songcn206/UnMannedParachuteController/Mechanics/Parts/LangevarjuKarpver2.SLDASM

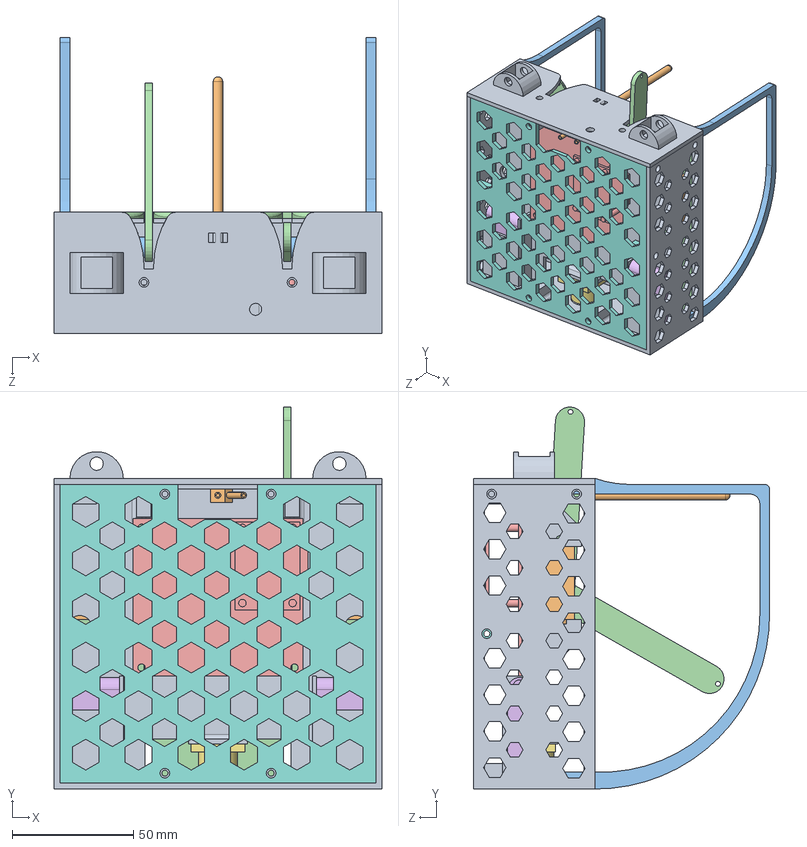
[picture p1: CAD file, 2020-04-21]
Mechanics/Parts/LangevarjuKarpver2.SLDASM
135.0 x 157.4 x 122.0 mm
LangevarjuKarbiSkelettVer2
FeetechFT1117MMotor x 2
MootoriAdapterVer2 x 2
Esisein
MainboardRev1
NanotechBattery x 2
SonarMB1023
Tagasein
Katus
PitotToru
Kaitsekaar x 2
Käppver2 x 2
