songcn206/UnMannedParachuteController/Mechanics/Parts/LangevarjuKarpver3.SLDASM

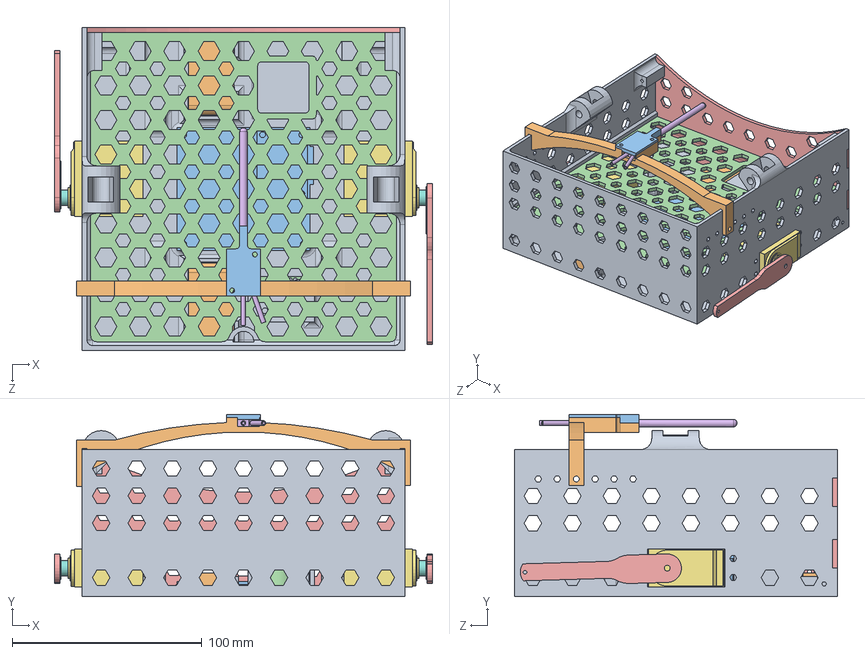
[picture p2: CAD file, 2020-03-24]
Mechanics/Parts/LangevarjuKarpver3.SLDASM
199.2 x 96.1 x 170.0 mm
LangevarjuKarbiSkelettVer3
NanotechBattery x 2
MainboardRev1
SonarMB1023
Käpp x 2
PitotToru
PololuAB3606HB x 2
MootoriAdapterVer3 x 2
GPSantenn
Pitotkaat
Pitotkatus
Vahekatusver3
Esiseinver3
