songcn206/UnMannedParachuteController/Mechanics/Parts/MainboardRev1.SLDPRT

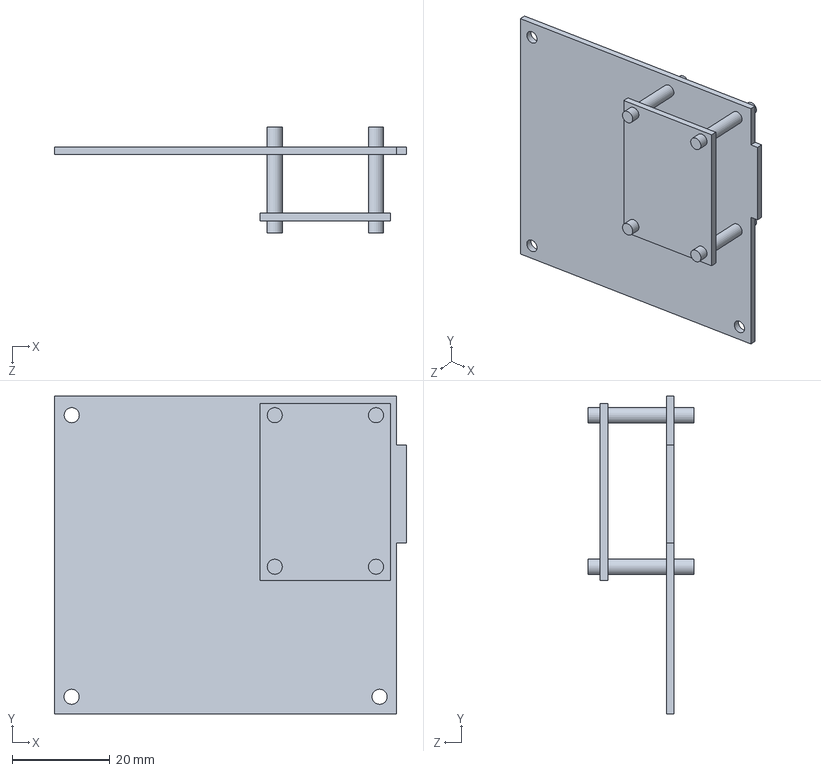
[picture p3: CAD file, 2020-03-01]
Mechanics/Parts/MainboardRev1.SLDPRT
72.0 x 65.0 x 21.6 mm
