songcn206/UnMannedParachuteController/Mechanics/Parts/NööriAas.SLDPRT

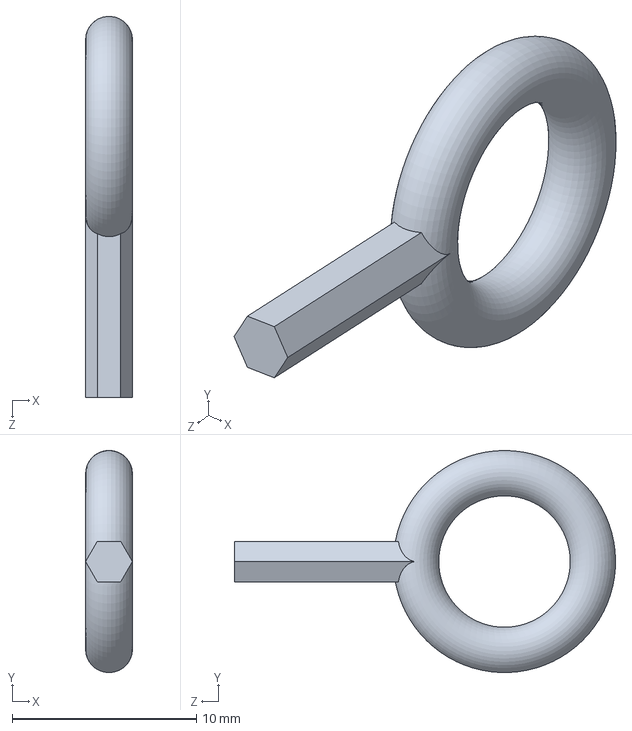
[picture p4: CAD file, 2020-04-21]
Mechanics/Parts/NööriAas.SLDPRT
2.54 x 12.1 x 20.7 mm
