songcn206/UnMannedParachuteController/Mechanics/Parts/Ver1esitagasein.SLDPRT

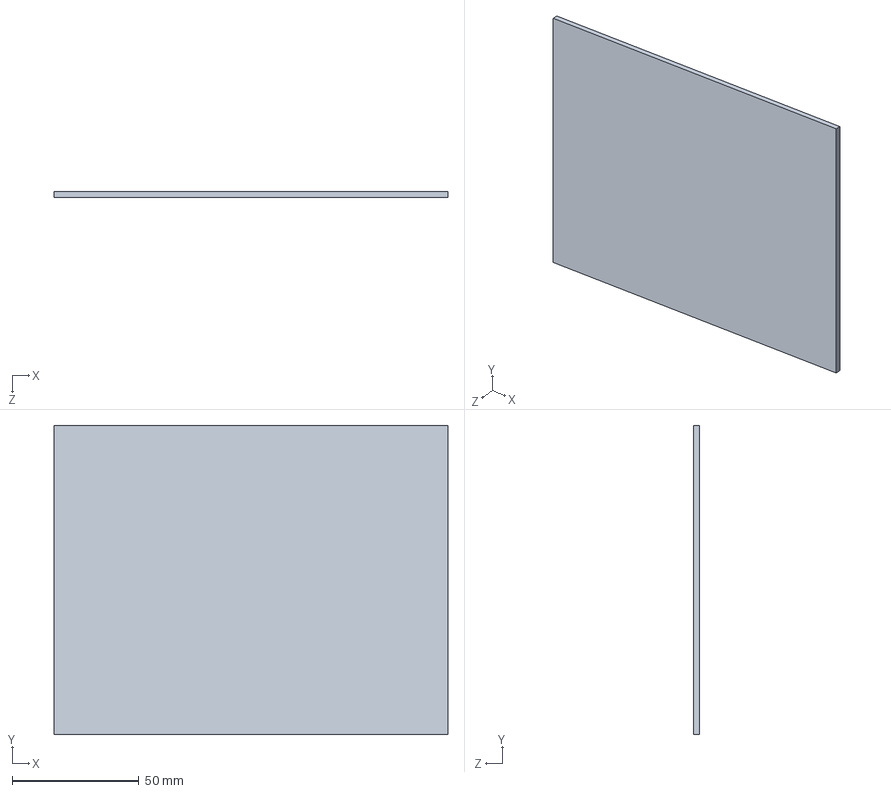
[picture p5: CAD file, 2020-04-21]
Mechanics/Parts/Ver1esitagasein.SLDPRT
155.4 x 122.0 x 2.50 mm
