songcn206/UnMannedParachuteController/Mechanics/Parts/TestRack.SLDPRT

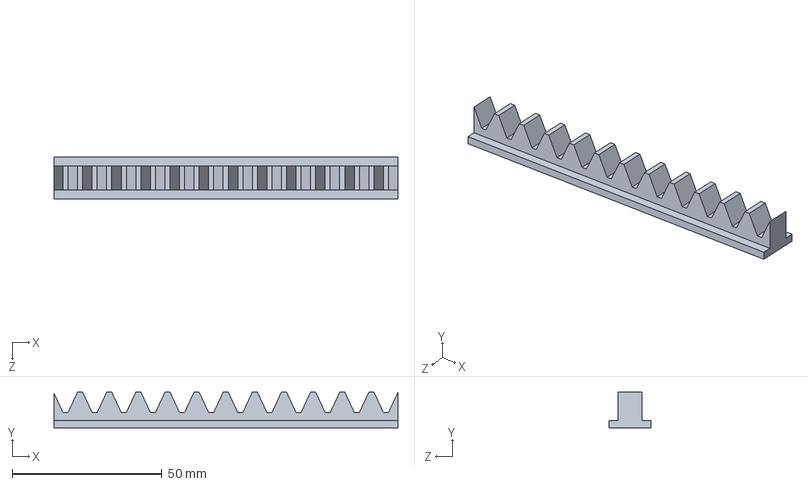
[picture p6: CAD file, 2020-04-21]
Mechanics/Parts/TestRack.SLDPRT
115.0 x 12.0 x 14.0 mm
