songcn206/UnMannedParachuteController/Mechanics/Parts/Esisein.SLDPRT

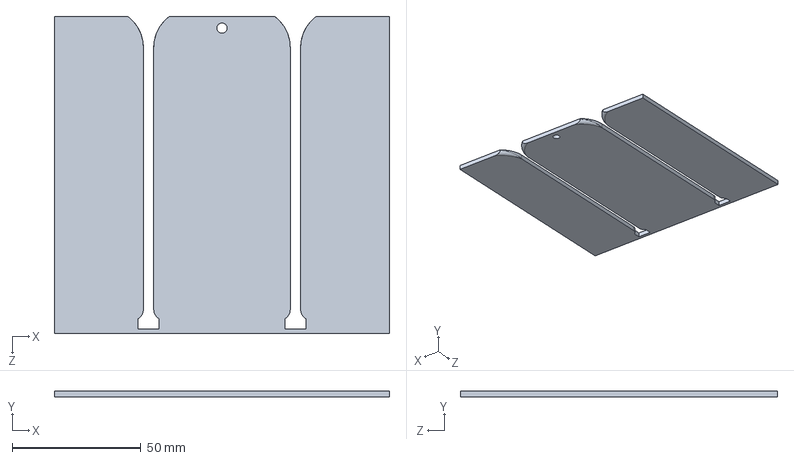
[picture p7: CAD file, 2020-04-21]
Mechanics/Parts/Esisein.SLDPRT
130.0 x 2.50 x 123.0 mm
