songcn206/UnMannedParachuteController/Mechanics/Parts/ver1katus.SLDPRT

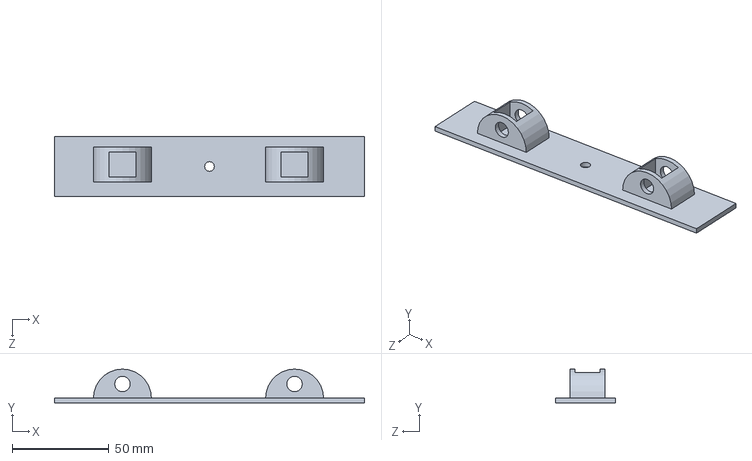
[picture p8: CAD file, 2020-04-21]
Mechanics/Parts/ver1katus.SLDPRT
160.4 x 17.5 x 31.0 mm
