songcn206/UnMannedParachuteController/Mechanics/Parts/Käppver2.SLDPRT

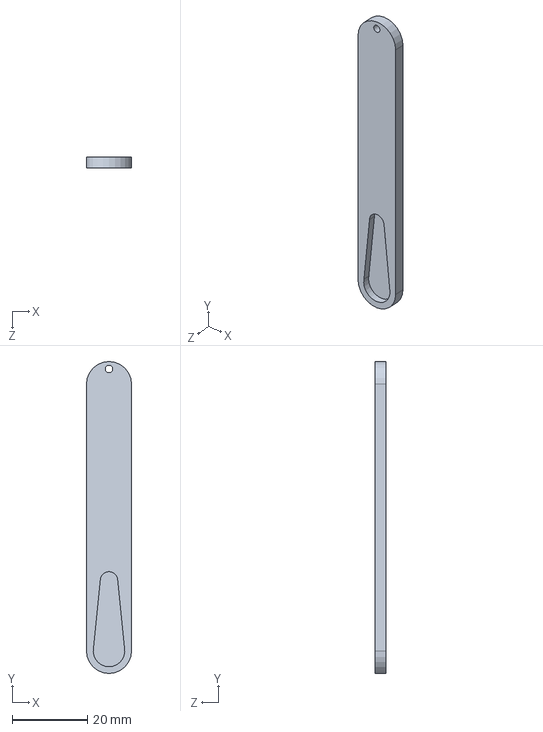
[picture p9: CAD file, 2020-04-21]
Mechanics/Parts/Käppver2.SLDPRT
12.0 x 83.0 x 3.00 mm
