songcn206/UnMannedParachuteController/Mechanics/Parts/SonarMB1023.SLDPRT

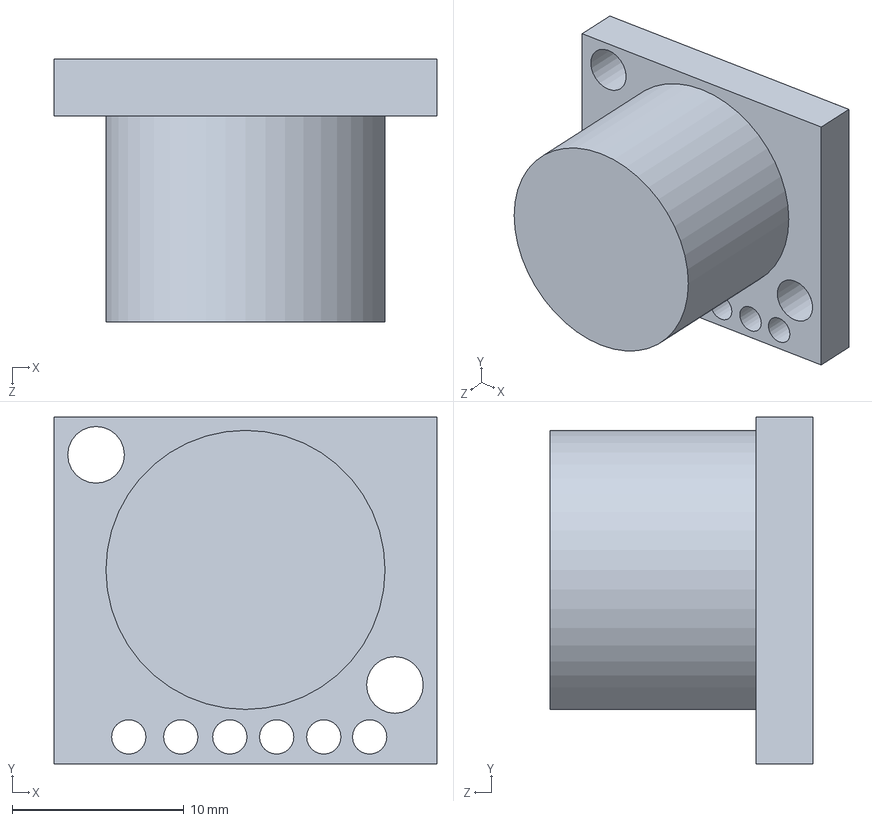
[picture p10: CAD file, 2020-03-24]
Mechanics/Parts/SonarMB1023.SLDPRT
22.3 x 20.2 x 15.3 mm
