songcn206/UnMannedParachuteController/Mechanics/Parts/Käpp.SLDPRT

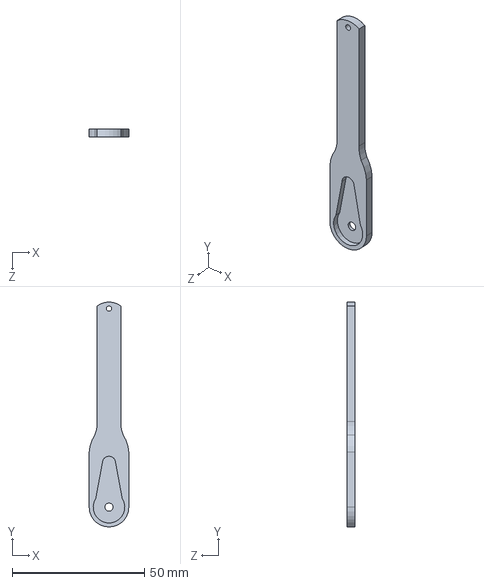
[picture p11: CAD file, 2020-03-24]
Mechanics/Parts/Käpp.SLDPRT
15.0 x 85.0 x 3.00 mm
