songcn206/UnMannedParachuteController/Mechanics/Parts/NanotechBattery.SLDPRT

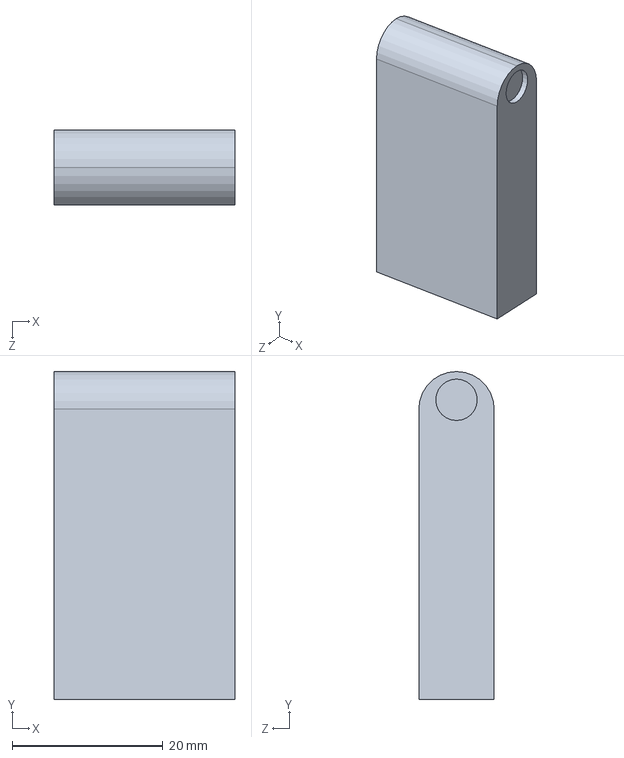
[picture p12: CAD file, 2020-03-01]
Mechanics/Parts/NanotechBattery.SLDPRT
24.0 x 43.5 x 10.0 mm
