songcn206/UnMannedParachuteController/Mechanics/Parts/MootoriAdapterVer3.SLDPRT

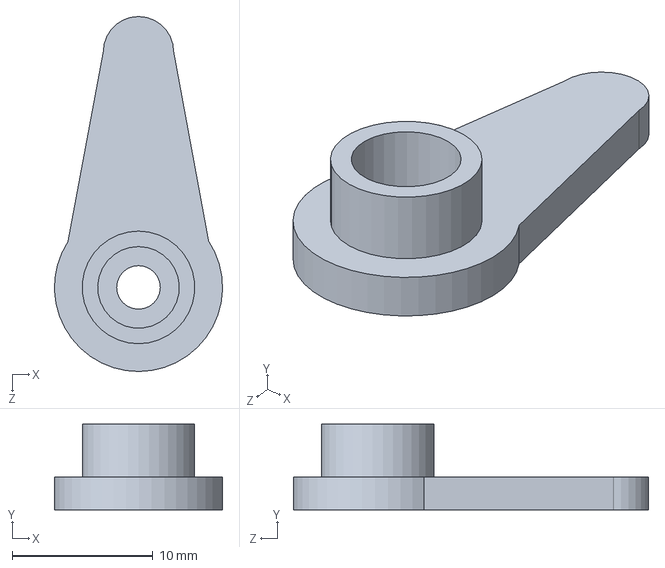
[picture p13: CAD file, 2020-03-01]
Mechanics/Parts/MootoriAdapterVer3.SLDPRT
11.9 x 6.10 x 25.2 mm
