songcn206/UnMannedParachuteController/Mechanics/Parts/LangevarjuKarbiSkelettVer3.SLDPRT

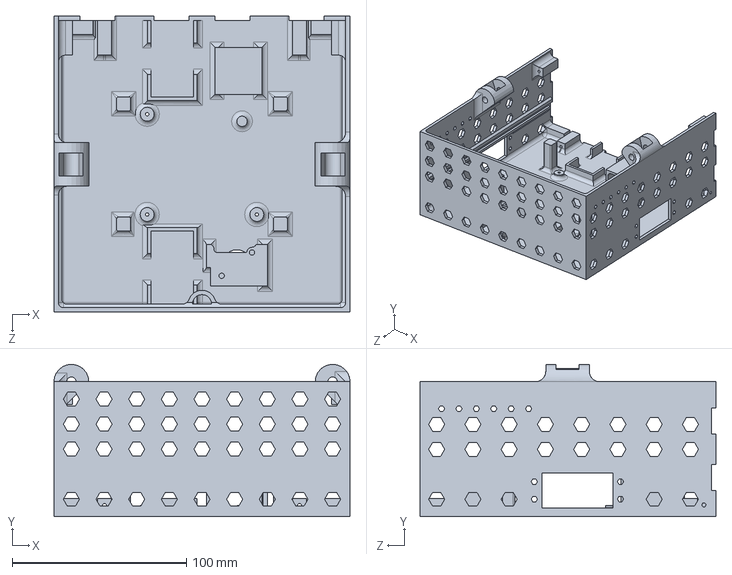
[picture p14: CAD file, 2020-03-01]
Mechanics/Parts/LangevarjuKarbiSkelettVer3.SLDPRT
170.0 x 87.5 x 170.0 mm
