songcn206/UnMannedParachuteController/Mechanics/Parts/Pitotkatus.SLDPRT

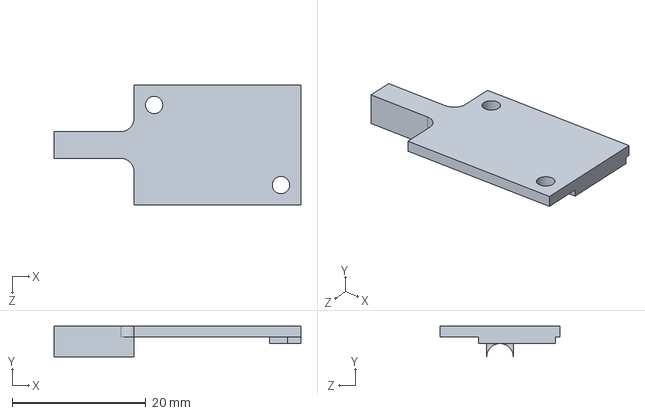
[picture p15: CAD file, 2020-03-01]
Mechanics/Parts/Pitotkatus.SLDPRT
37.0 x 4.60 x 18.0 mm
