songcn206/UnMannedParachuteController/Mechanics/Parts/Esiseinver3.sldprt

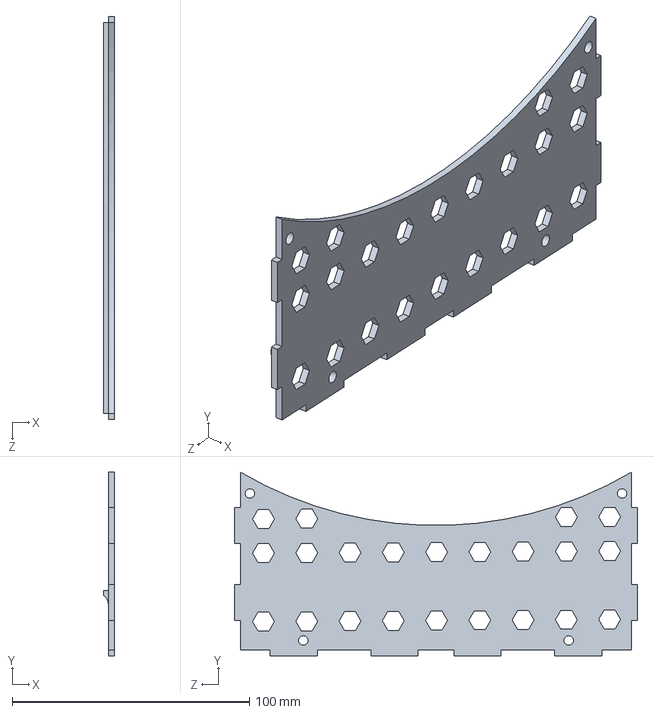
[picture p16: CAD file, 2020-03-01]
Mechanics/Parts/Esiseinver3.sldprt
4.50 x 77.5 x 170.0 mm
