songcn206/UnMannedParachuteController/Mechanics/Parts/Pitotkaat.SLDPRT

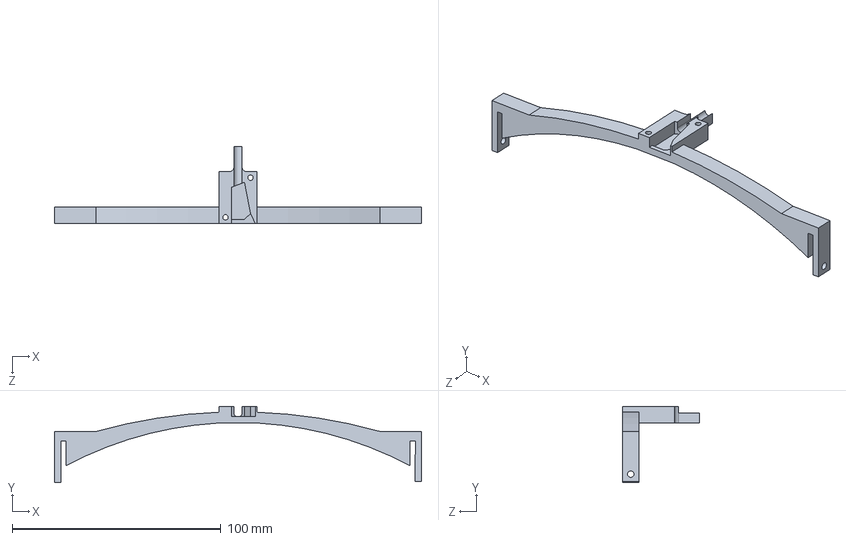
[picture p17: CAD file, 2020-03-01]
Mechanics/Parts/Pitotkaat.SLDPRT
176.0 x 36.5 x 37.0 mm
