songcn206/UnMannedParachuteController/Mechanics/Parts/Vahekatusver3.SLDPRT

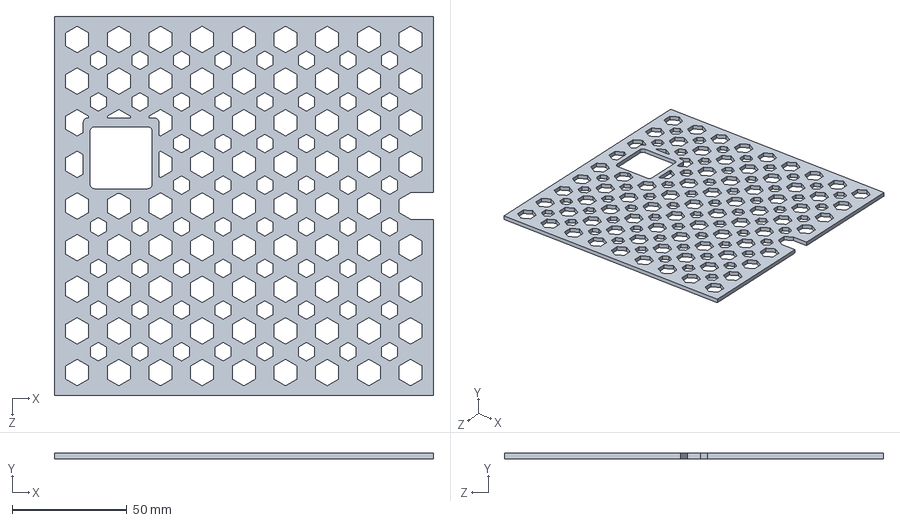
[picture p18: CAD file, 2020-03-01]
Mechanics/Parts/Vahekatusver3.SLDPRT
165.0 x 2.50 x 165.0 mm
