songcn206/UnMannedParachuteController/Mechanics/Parts/PitotToru.SLDPRT

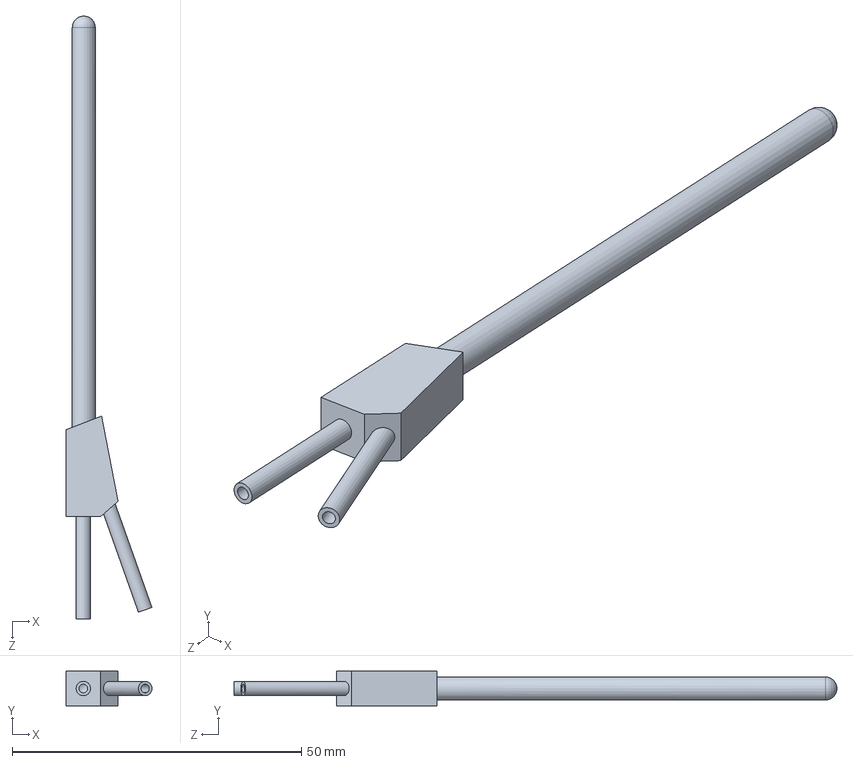
[picture p19: CAD file, 2020-03-01]
Mechanics/Parts/PitotToru.SLDPRT
14.9 x 6.00 x 104.2 mm
