songcn206/UnMannedParachuteController/Mechanics/Parts/PololuAB3606HB.SLDPRT

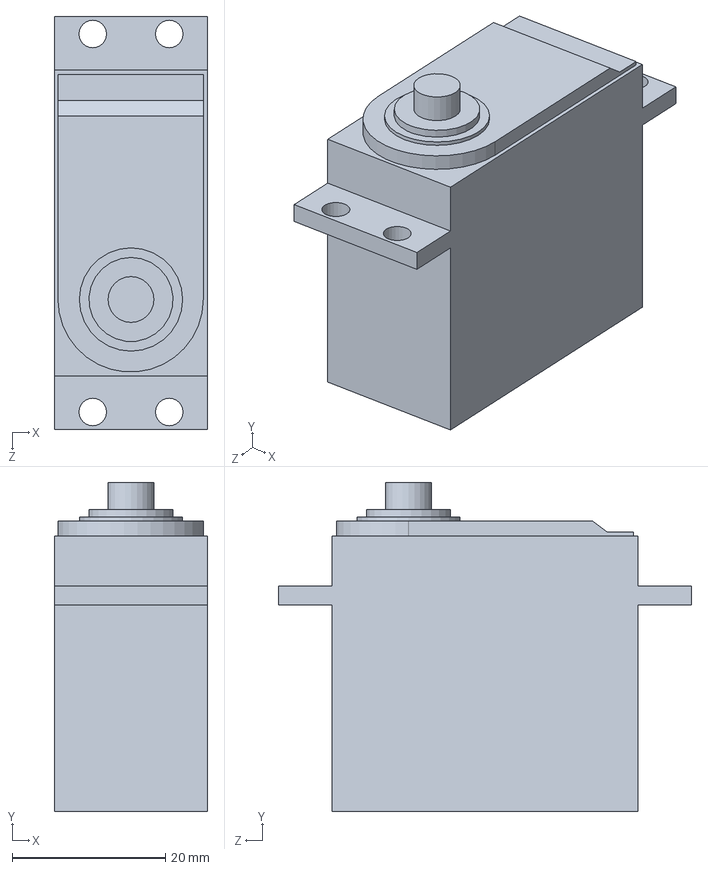
[picture p20: CAD file, 2020-03-01]
Mechanics/Parts/PololuAB3606HB.SLDPRT
20.0 x 43.0 x 54.0 mm
