songcn206/UnMannedParachuteController/Mechanics/Parts/GPSantenn.SLDPRT

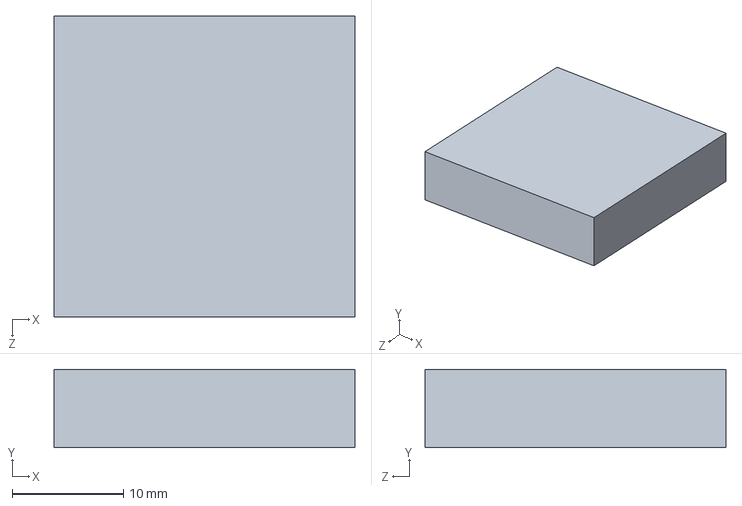
[picture p21: CAD file, 2020-03-01]
Mechanics/Parts/GPSantenn.SLDPRT
27.0 x 7.00 x 27.0 mm
