songcn206/UnMannedParachuteController/Mechanics/Parts/Vahekatus.SLDPRT

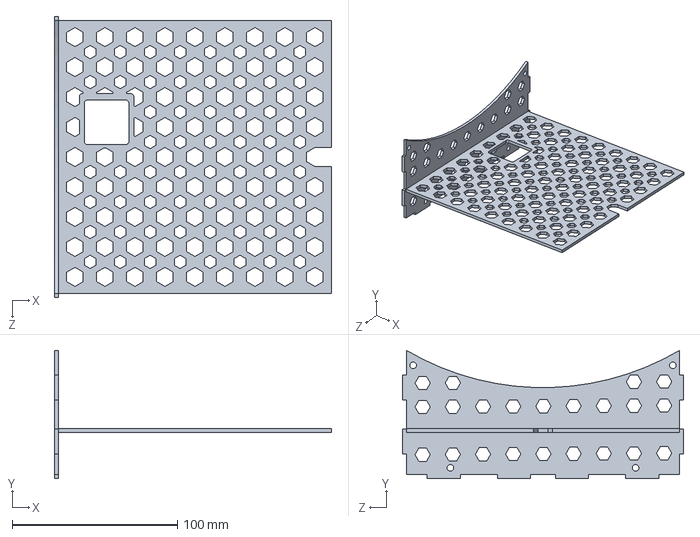
[picture p22: CAD file, 2020-02-24]
Mechanics/Parts/Vahekatus.SLDPRT
167.5 x 77.5 x 170.0 mm
