songcn206/UnMannedParachuteController/Mechanics/Parts/Tagasein.SLDPRT

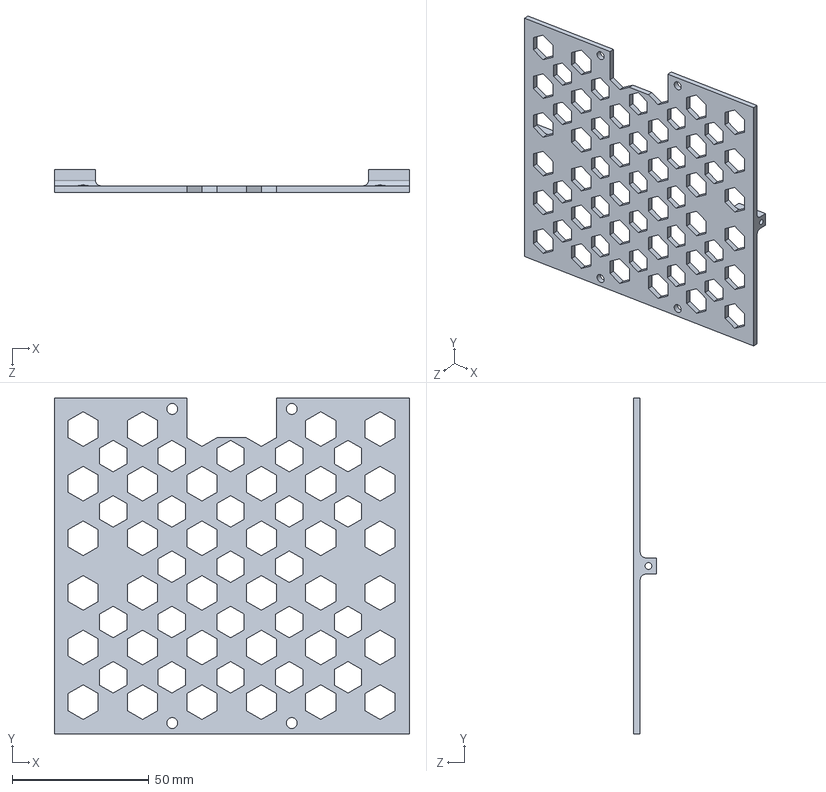
[picture p23: CAD file, 2020-02-20]
Mechanics/Parts/Tagasein.SLDPRT
130.0 x 123.0 x 8.50 mm
