songcn206/UnMannedParachuteController/Mechanics/Parts/FeetechFT1117MMotor.SLDPRT

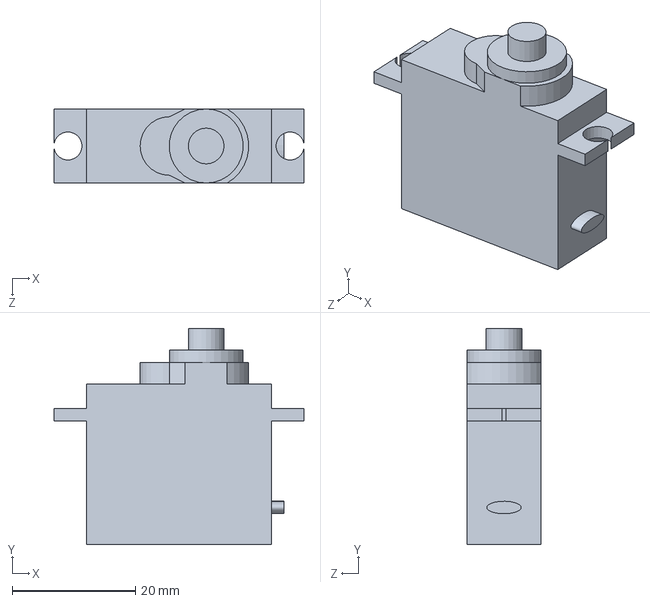
[picture p24: CAD file, 2020-02-20]
Mechanics/Parts/FeetechFT1117MMotor.SLDPRT
40.5 x 35.0 x 12.0 mm
