songcn206/UnMannedParachuteController/Mechanics/Parts/Gear65.SLDPRT

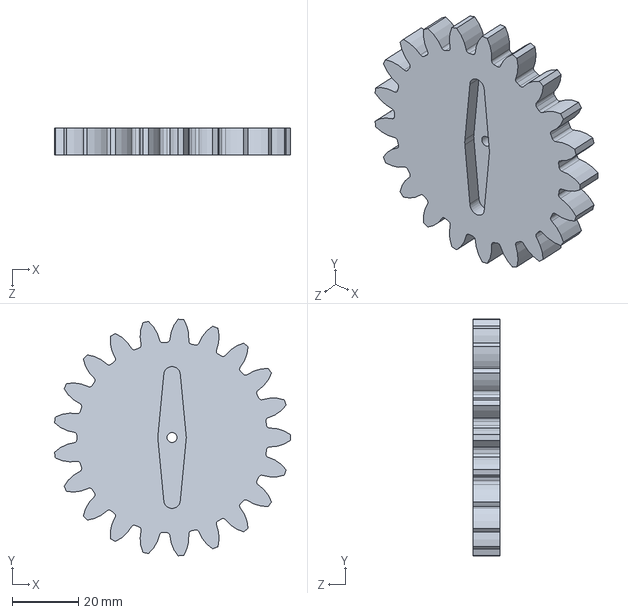
[picture p25: CAD file, 2020-02-20]
Mechanics/Parts/Gear65.SLDPRT
71.0 x 71.2 x 8.00 mm
