songcn206/UnMannedParachuteController/Mechanics/Parts/Drooni hoidja.SLDPRT

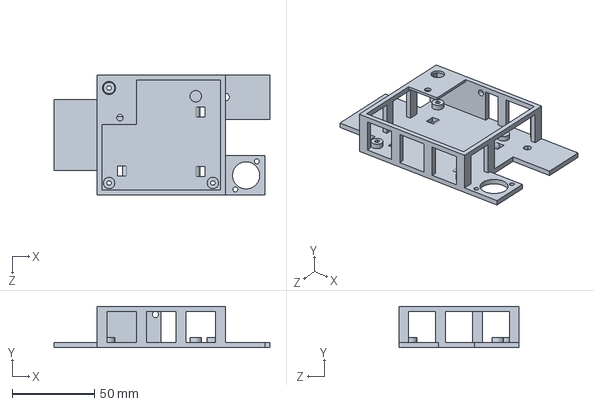
[picture p26: CAD file, 2020-02-20]
Mechanics/Parts/Drooni hoidja.SLDPRT
131.0 x 25.0 x 73.0 mm
