songcn206/UnMannedParachuteController/Mechanics/Parts/Gear63mm.SLDPRT

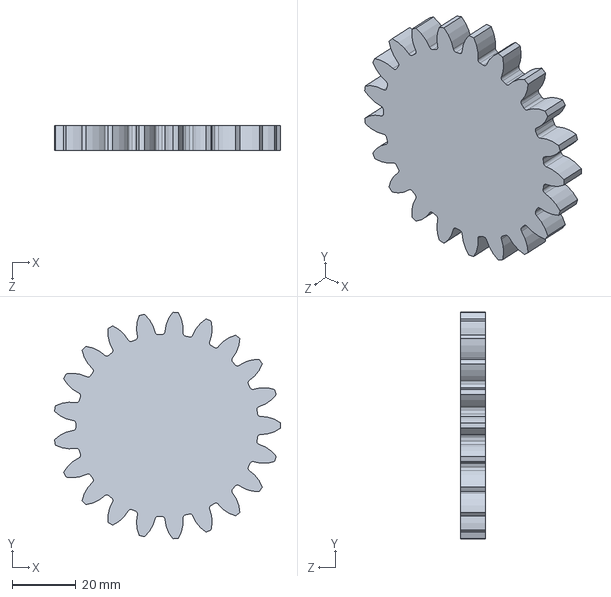
[picture p27: CAD file, 2020-02-20]
Mechanics/Parts/Gear63mm.SLDPRT
71.0 x 71.2 x 8.00 mm
