songcn206/UnMannedParachuteController/Mechanics/Parts/Põhi.SLDPRT

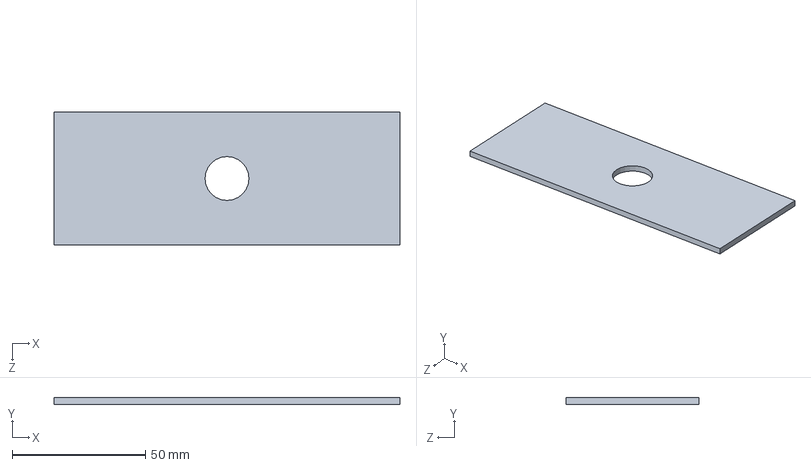
[picture p28: CAD file, 2020-02-20]
Mechanics/Parts/Põhi.SLDPRT
130.0 x 2.50 x 50.0 mm
