songcn206/UnMannedParachuteController/Mechanics/Parts/Katus.SLDPRT

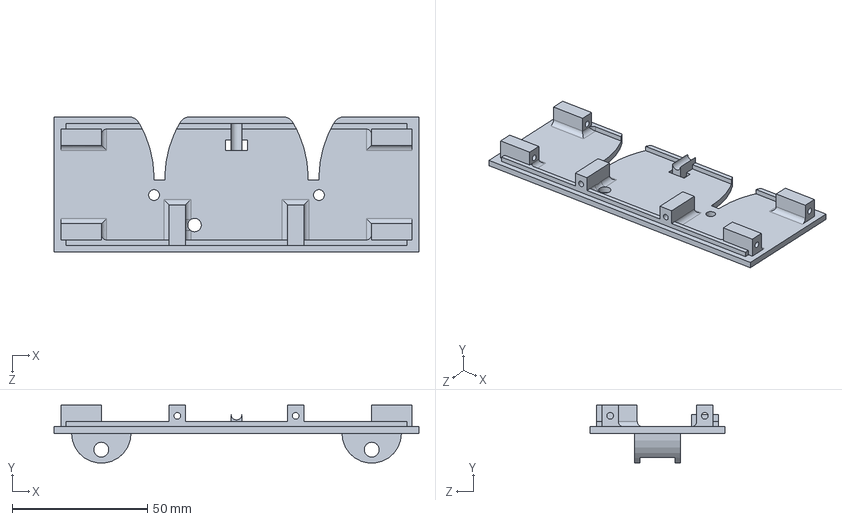
[picture p29: CAD file, 2020-02-20]
Mechanics/Parts/Katus.SLDPRT
135.0 x 21.4 x 50.0 mm
