songcn206/UnMannedParachuteController/Mechanics/Parts/Kaitsekaar.SLDPRT

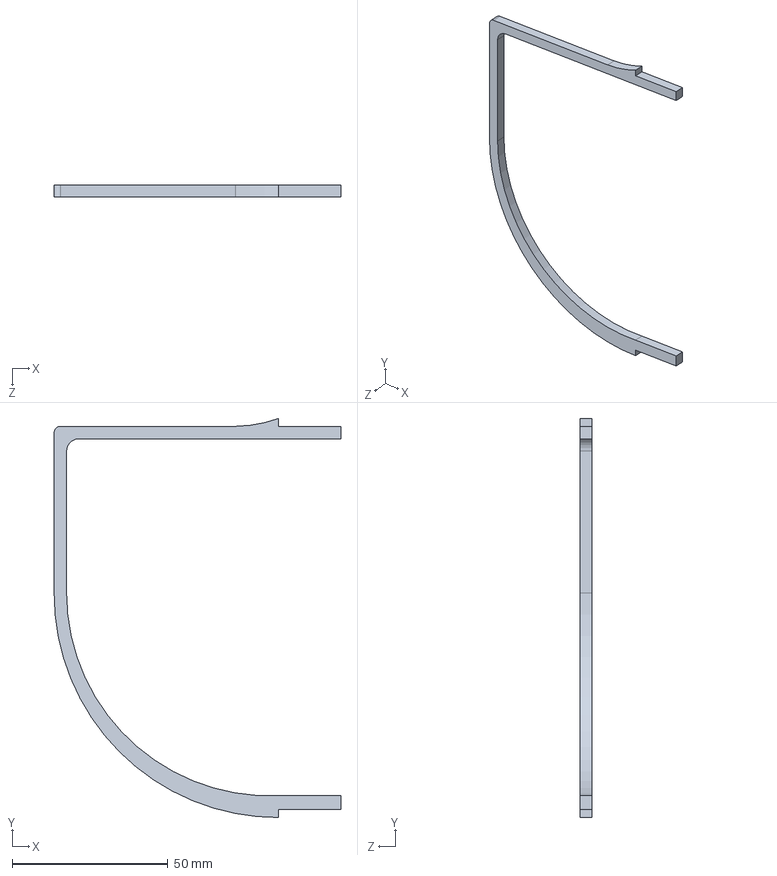
[picture p30: CAD file, 2020-02-20]
Mechanics/Parts/Kaitsekaar.SLDPRT
92.0 x 128.0 x 4.00 mm
