songcn206/UnMannedParachuteController/Mechanics/Parts/TestGear.SLDPRT

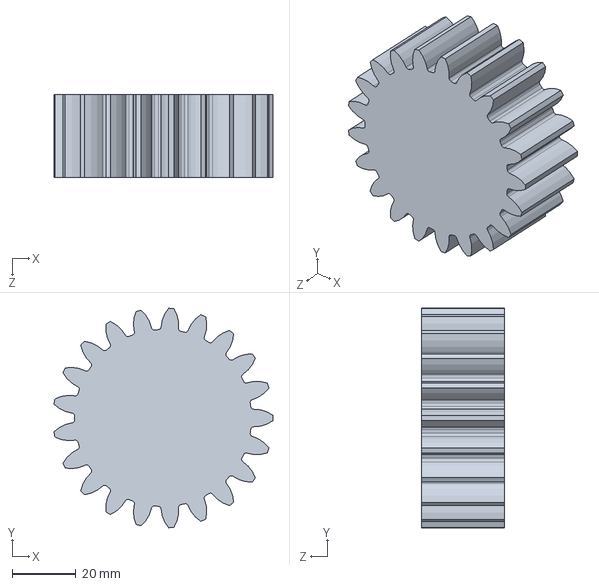
[picture p31: CAD file, 2020-02-20]
Mechanics/Parts/TestGear.SLDPRT
68.7 x 68.9 x 26.0 mm
