songcn206/UnMannedParachuteController/Mechanics/Parts/Langevarju hoidja.SLDPRT

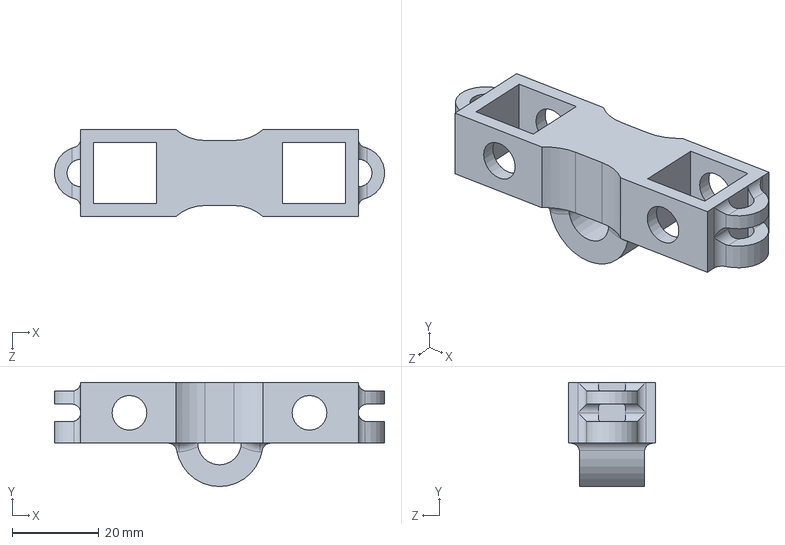
[picture p32: CAD file, 2019-12-04]
Mechanics/Parts/Langevarju hoidja.SLDPRT
76.1 x 24.0 x 20.0 mm
