songcn206/UnMannedParachuteController/(list of files, cad)

Other CAD files:
Mechanics/Parts/LangevarjuKarbiSkelett.SLDPRT
Mechanics/Parts/LangevarjuKarbiSkelettVer2.SLDPRT
Mechanics/Parts/MootoriAdapter.SLDPRT
Mechanics/Parts/MootoriAdapterVer2.SLDPRT
