songcn206/UnMannedParachuteController/(list of files, drawings)

Other design files:
Electronics/Barometers.SchDoc
Electronics/GPS.SchDoc
Electronics/IMUAndSonar.SchDoc
Electronics/MainSheet.SchDoc
Electronics/MCU.SchDoc
Electronics/Motors.SchDoc
Electronics/Power.SchDoc
Electronics/Uarts.SchDoc
Electronics/UMParachuteContr.PcbDoc
Electronics/UMParachuteContr.PrjPCB
