songcn206/UnMannedParachuteController/Firmware/UnMannedParachuteController/UnMannedParachuteController/HAL/UART/ParseUart.hpp

/*
 * ParseUart.h
 *
 * Created: 09.01.2020 14:11:48
 *  Author: timot
 */ 


#ifndef PARSEUART_HPP_
#define PARSEUART_HPP_

#include "HAL/UART/UART.hpp"
#include "HAL/System/Pins.hpp"
#include "HAL/Timers/GenericTimer/GenTimerD0.hpp"
#include "HAL/Timers/GenericTimer/GenTimerE0.hpp"
#include "HAL/DataPackets/DataPackets.hpp"
#include "Control/Servos/Servos.hpp"
#include <stdlib.h>
#include <stdio.h>
#include <inttypes.h>

class ParseExtUart {
	private:
		static volatile uint8_t* arrayStartPointer;
		static volatile uint8_t* arrayEndPointer;
		static volatile uint8_t* runningPointer;

		static constexpr char terminatingChar = DebugUart :: terminatingChar;
		static constexpr uint8_t parseBufferSize = 50;	
		
		static uint8_t parseBuffer[parseBufferSize];
		static uint8_t parseBufferPos;
		
	public:
		static void Parse() {
			while (GetDataSafe(runningPointer) != 0) {
				uint8_t data = GetDataSafe(runningPointer);
				parseBuffer[parseBufferPos] = data;
				SetDataSafe(runningPointer, 0);
				if (data == terminatingChar) {
					
					if (MatchCommands(&parseBuffer[0], parseBufferPos, "save", sizeof("save"))) {
						HandleSaveData();
						
					} else if (MatchCommands(&parseBuffer[0], parseBufferPos, "get", sizeof("get"))) {
						HandleGetData();
						
					} else if (MatchCommands(&parseBuffer[0], parseBufferPos, "cancel", sizeof("cancel"))) {
						HandleCancelData();
						
					} else if (MatchCommands(&parseBuffer[0], parseBufferPos, "left", sizeof("left"))) {
						HandleSetLeftMotorPosition(&parseBuffer[0], parseBufferPos);
						
					} else if (MatchCommands(&parseBuffer[0], parseBufferPos, "right", sizeof("right"))) {
						HandleSetRightMotorPosition(&parseBuffer[0], parseBufferPos);
						
					} else if (MatchCommands(&parseBuffer[0], parseBufferPos, "both", sizeof("both"))) {
						HandleSetBothMotorPosition(&parseBuffer[0], parseBufferPos);
						
					} else if (MatchCommands(&parseBuffer[0], parseBufferPos, "autoon", sizeof("autoon"))) {
						HandleAutoOn();
						
					} else if (MatchCommands(&parseBuffer[0], parseBufferPos, "autooff", sizeof("autooff"))) {
						HandleAutoOff();
					}
					
					for (uint8_t i = 0; i < parseBufferPos; i++) {
						parseBuffer[i] = 0;
					}
					
					parseBufferPos = parseBufferSize - 1; 
				}
				
				if (runningPointer == arrayEndPointer) {
					runningPointer = arrayStartPointer;
				} else {
					runningPointer++;
				}
				
				if (parseBufferPos == parseBufferSize - 1) {
					parseBufferPos = 0;
				} else {
					parseBufferPos++;
				}
			}
		}

		static uint8_t GetDataSafe(volatile uint8_t* pointer) {
			System :: DisableInterruptsByPriority(DebugUart :: GetInterruptLevel());
			uint8_t tempData = *pointer;
			System :: EnableInterruptsByPriority(DebugUart :: GetInterruptLevel());
			return tempData;
		}

		static void SetDataSafe(volatile uint8_t* pointer, uint8_t data) {
			System :: DisableInterruptsByPriority(DebugUart :: GetInterruptLevel());
			*pointer = data;
			System :: EnableInterruptsByPriority(DebugUart :: GetInterruptLevel());
		}

		static bool MatchCommands(uint8_t* pointer, uint8_t bufferlength, const char* command, uint8_t commandLength) {
			if (bufferlength < commandLength - 1) {
				return false;
			}
			for (uint8_t i = 0; i < commandLength - 1; i++) {
				if (*pointer != *command) {
					return false;
				}
				pointer++;
				command++;
			}
			return true;
		}
		
		// Turning off all sensor communication
		static void HandleGetData() {
			GenTimerD0 :: StopImuDataCommunication();
			GenTimerD0 :: StopSonarMeasurements();
			GenTimerE0 :: StopAbsBaroCommunication();
			GenTimerE0 :: StopDiffBaroCommunication();
			GpsUart :: DisableRX();
			DataPackets :: SendDataFromArray();
			GpsUart :: EnableRX();
			GenTimerD0 :: StartImuDataCommunication();
			GenTimerD0 :: StartSonarMeasurements();
			GenTimerE0 :: StartAbsBaroCommunication();
			GenTimerE0 :: StartDiffBaroCommunication();
		}
		
		static void HandleSaveData() {
			DataPackets :: StartSavingData();
		}
		
		static void HandleCancelData() {
			DataPackets :: CancelSavingData();
		}
		
		static void HandleSetLeftMotorPosition(uint8_t* bufferpointer, uint8_t parseBufferLen) {
			uint8_t len = 0;
			while (bufferpointer[5 + len] != terminatingChar) {
				len++;
				if (len >= 4) {
					break;
				}
			}
			if (len <= 5 && len >= 0) {
				uint16_t position_mm = StringToUint16((const char*)&bufferpointer[5], len);
				if (position_mm >= 0 && position_mm <= 150) {
					Servos :: SetLeftMotorPosition(position_mm);
				}
			}
		}
		
		static void HandleSetRightMotorPosition(uint8_t* bufferpointer, uint8_t parseBufferLen) {
			uint8_t len = 0;
			while (bufferpointer[6 + len] != terminatingChar) {
				len++;
				if (len >= 4) {
					break;
				}
			}
			if (len <= 3 && len >= 0) {
				uint8_t position_mm = StringToUint8((const char*)&bufferpointer[6], len);
				if (position_mm >= 0 && position_mm <= 150) {
					Servos :: SetRightMotorPosition(position_mm);
				}
			}
		}
		
		static void HandleSetBothMotorPosition(uint8_t* bufferpointer, uint8_t parseBufferLen) {
			uint8_t len = 0;
			while (bufferpointer[5 + len] != terminatingChar) {
				len++;
				if (len >= 4) {
					break;
				}
			}
			if (len <= 3 && len >= 0) {
				uint8_t position_mm = StringToUint8((const char*)&bufferpointer[5], len);
				if (position_mm >= 0 && position_mm <= 150) {
					Servos :: SetLeftMotorPosition(position_mm);
					Servos :: SetRightMotorPosition(position_mm);
				}
			}
		}
		
		static void HandleAutoOn() {
			Servos :: SetAutoControlMotors(true);
		}
		
		static void HandleAutoOff() {
			Servos :: SetAutoControlMotors(false);
		}
		
		// just using basic math to convert ASCII string to number
		static uint8_t StringToUint8(const char* pointer, uint8_t len) {
			if (len == 3) {
				return 100 * (pointer[0] - 0b00110000)  + 10 * (pointer[1] - 0b00110000) + (pointer[2] - 0b00110000);
			} else if (len == 2) {
				return 10 * (pointer[0] - 0b00110000) + (pointer[1] - 0b00110000);
			} else {
				return pointer[0] - 0b00110000;
			}
		}
		
		// just using basic math to convert ASCII string to number
		static uint16_t StringToUint16(const char* pointer, uint8_t len) {
			if (len == 5) {
				return 10000 * (pointer[0] - 0b00110000) + 1000 * (pointer[1] - 0b00110000) 
						+ 100 * (pointer[2] - 0b00110000)  + 10 * (pointer[3] - 0b00110000) + (pointer[4] - 0b00110000);
			} else if (len == 4) {
				return 1000 * (pointer[0] - 0b00110000) + 100 * (pointer[1] - 0b00110000)  + 10 * (pointer[2] - 0b00110000) + (pointer[3] - 0b00110000);
			} else if (len == 3) {
				return 100 * (pointer[0] - 0b00110000)  + 10 * (pointer[1] - 0b00110000) + (pointer[2] - 0b00110000);
			} else if (len == 2) {
				return 10 * (pointer[0] - 0b00110000) + (pointer[1] - 0b00110000);
			} else {
				return pointer[0] - 0b00110000;
			}
		}
};

class ParseGPSUart {
	private:
		static volatile uint8_t* arrayStartPointer;
		static volatile uint8_t* arrayEndPointer;
		static volatile uint8_t* runningPointer;

		static constexpr char terminatingChar = GpsUart :: terminatingChar;
		static constexpr uint8_t parseBufferSize = 200;
		
		static uint8_t parseBuffer[parseBufferSize];
		static uint8_t parseBufferPos;

		static float volatile latitude;
		static float volatile longitude;
		static float volatile altitude;
		static uint8_t volatile gpsCount;
	
	public:
		static void Parse() {
			while (GetDataSafe(runningPointer) != 0) {
				uint8_t data = GetDataSafe(runningPointer);
				parseBuffer[parseBufferPos] = data;
				SetDataSafe(runningPointer, 0);
				if (data == terminatingChar) {
					
					if (MatchCommands(&parseBuffer[0], parseBufferPos, "$PUBX", sizeof("$PUBX"))) {
						HandlePUBXCommand(&parseBuffer[0], parseBufferPos);
					} 
					
					parseBufferPos = parseBufferSize - 1; 
				}
				
				if (runningPointer == arrayEndPointer) {
					runningPointer = arrayStartPointer;
				} else {
					runningPointer++;
				}
				
				if (parseBufferPos == parseBufferSize - 1) {
					parseBufferPos = 0;
				} else {
					parseBufferPos++;
				}
			}
		}
		
		static uint8_t GetDataSafe(volatile uint8_t* pointer) {
			System :: DisableInterruptsByPriority(GpsUart :: GetInterruptLevel());
			uint8_t tempData = *pointer;
			System :: EnableInterruptsByPriority(GpsUart :: GetInterruptLevel());
			return tempData;
		}

		static void SetDataSafe(volatile uint8_t* pointer, uint8_t data) {
			System :: DisableInterruptsByPriority(GpsUart :: GetInterruptLevel());
			*pointer = data;
			System :: EnableInterruptsByPriority(GpsUart :: GetInterruptLevel());
		}
		
		static bool MatchCommands(uint8_t* pointer, uint8_t bufferlength, const char* command, uint8_t commandLength) {
			if (bufferlength < commandLength - 1) {
				return false;
			}
			for (uint8_t i = 0; i < commandLength - 1; i++) {
				if (*pointer != *command) {
					return false;
				}
				pointer++;
				command++;
			}
			return true;
		}
		
		static void HandlePUBXCommand(uint8_t* bufferpointer, uint8_t parseBufferLen) {
			uint8_t gpsDataStartArray[21] = {};
			uint8_t gpsDataPosition = 0;
			gpsDataStartArray[gpsDataPosition] = 0;
			gpsDataPosition++;
			
			for(uint8_t i = 0; i < parseBufferLen; i++) {
				if (bufferpointer[i] == ',') {
					gpsDataStartArray[gpsDataPosition] = i + 1;
					gpsDataPosition++;
				}
			}

			uint8_t latitudePos = gpsDataStartArray[3];
			uint8_t longitudePos = gpsDataStartArray[5];
			uint8_t altitudePos = gpsDataStartArray[7];
			uint8_t gpsCountPos = gpsDataStartArray[18];
			
			char tempLatitude[10];
			char tempLongitude[11];
			char tempAltitude[7];
			char tempGpsCount[2];
			
			for (uint8_t i = 0; i <  (gpsDataStartArray[4] - 1 - latitudePos); i++) {
				tempLatitude[i] = bufferpointer[latitudePos + i];
			}

			for (uint8_t i = 0; i <  (gpsDataStartArray[6] - 1 - longitudePos); i++) {
				tempLongitude[i] = bufferpointer[longitudePos + i];
			}	
			
			for (uint8_t i = 0; i <  (gpsDataStartArray[8] - 1 - altitudePos); i++) {
				tempAltitude[i] = bufferpointer[altitudePos + i];
			}
			
			for (uint8_t i = 0; i <  (gpsDataStartArray[19] - 1 - gpsCountPos); i++) {
				tempGpsCount[i] = bufferpointer[gpsCountPos + i];
			}		
				
			//dateTime = StringToFloat(tempDateTime, sizeof(tempDateTime), 6);
			//latitude = StringToFloat(tempLatitude, gpsDataStartArray[4] - 1 - latitudePos, 4);
			//longitude = StringToFloat(tempLongitude, gpsDataStartArray[6] - 1 - longitudePos, 5);
			//altitude = StringToFloat(tempAltitude, gpsDataStartArray[8] - 1 - altitudePos, altitudePointPos);
			gpsCount = StringToUint8(tempGpsCount, gpsDataStartArray[19] - 1 - gpsCountPos);
			
			//latitude2 = StringToDouble(tempLatitude, sizeof(tempLatitude), 6);
			
			latitude = atof(tempLatitude);
			longitude = atof(tempLongitude);
			altitude = atof(tempAltitude);
			
			led1 :: Toggle();
		}
		
		static uint8_t StringToUint8(const char* pointer, uint8_t len) {
			if (len == 3) {
				return 100 * (pointer[0] - 0b00110000)  + 10 * (pointer[1] - 0b00110000) + (pointer[2] - 0b00110000);
			} else if (len == 2) {
				return 10 * (pointer[0] - 0b00110000) + (pointer[1] - 0b00110000);
			} else {
				return pointer[0] - 0b00110000;
			}
		}
		
		// Based on tests it is slower than atof
		static float StringToFloat(const char* pointer, uint8_t len, uint8_t pointPos) {
			float result = 0.0f;
			
			uint8_t tempValue;
			float powerOf = (float)findPowerOf(10, pointPos - 1);
			for (uint8_t i = 0; i < len; i++) {
				if (i != pointPos) {
					tempValue = pointer[i] - 0b00110000;
					result += tempValue * powerOf;
					powerOf = powerOf / 10.0f;
				}
			}
			return result;
		}
		 
		static uint32_t findPowerOf(uint8_t base, uint8_t exponent) {
			uint32_t result = 1;
			for (uint8_t i = 0; i < exponent; i++) {
				result = result * base;
			}
			return result;		
		}
		
		static float GetLatitude() {
			return latitude;
		}
		
		static float GetLongitude() {
			return longitude;
		}
		
		static float GetAltitude() {
			return altitude;
		}
		
		static uint8_t GetGPSCount() {
			return gpsCount;
		}
};
#endif /* PARSEUART_H_ */
