songcn206/UnMannedParachuteController/Firmware/UnMannedParachuteController/UnMannedParachuteController/HAL/UART/UART.cpp

/*
 * UART.cpp
 *
 * Created: 07.01.2020 21:12:04
 *  Author: timot
 */ 

#include "UART.hpp"

ISR(USARTF0_RXC_vect) {
	ExtUart :: ExtRxInterruptHandler();
}

ISR(USARTE0_RXC_vect) {
	DebugUart :: ExtRxInterruptHandler();
}

ISR(USARTD0_RXC_vect) {
	GpsUart :: GPSRxInterruptHandler();	
}
