songcn206/UnMannedParachuteController/Firmware/UnMannedParachuteController/UnMannedParachuteController/HAL/Timers/GenericTimer/GenTimerE0.cpp

/*
 * GenTimerE0.cpp
 *
 * Created: 28.01.2020 20:54:04
 *  Author: timot
 */ 

#include "GenTimerE0.hpp"
#include "HAL/SPI/AbsSpi.hpp"
#include "HAL/I2C/I2C.hpp"

volatile constexpr uint16_t GenTimerE0 :: compareMatchAValue;
volatile constexpr uint16_t GenTimerE0 :: compareMatchBValue;
volatile constexpr uint16_t GenTimerE0 :: compareMatchCValue;

volatile bool GenTimerE0 :: autoControl = false;

ISR(TCE0_CCA_vect) {
	GenTimerE0 :: CompareMatchAHandler();
}

ISR(TCE0_CCB_vect) {
	GenTimerE0 :: CompareMatchBHandler();
}

ISR(TCE0_CCC_vect) {
	GenTimerE0 :: CompareMatchCHandler();
}

void  GenTimerE0 :: Init() {
	TCE0.CTRLB = TC_WGMODE_NORMAL_gc;
	TCE0.INTCTRLB = 0;
	TCE0.PER = 65535;
	TCE0.CCA = GenTimerE0 :: compareMatchAValue;
	TCE0.CCB = GenTimerE0 :: compareMatchBValue;
	TCE0.CCC = GenTimerE0 :: compareMatchCValue;
	TCE0.INTCTRLB = TC_CCBINTLVL_LO_gc;
	TCE0.CTRLA = Timers :: GetPreScaler(GenTimerE0 :: preScaler);
}

void GenTimerE0 :: CompareMatchAHandler() {
	AbsSpi :: StartDataCommunication();
	TCE0.CCA += GenTimerE0 :: compareMatchAValue;
	TCE0.CTRLFSET = TC_CMD_UPDATE_gc;
}

void GenTimerE0 :: CompareMatchBHandler() {
	autoControl = true;
	TCE0.CCB += GenTimerE0 :: compareMatchBValue;
	TCE0.CTRLFSET = TC_CMD_UPDATE_gc;
}

void GenTimerE0 :: CompareMatchCHandler() {
	I2cDiffBaro :: GetData();
	TCE0.CCC += GenTimerE0 :: compareMatchCValue;
	TCE0.CTRLFSET = TC_CMD_UPDATE_gc;
}

void GenTimerE0 :: StartAbsBaroCommunication() {
	TCE0.INTCTRLB |= TC_CCAINTLVL_MED_gc;
}

void GenTimerE0 :: StopAbsBaroCommunication() {
	TCE0.INTCTRLB &= (0xff ^ (3 << 0));
}

void GenTimerE0 :: StartDiffBaroCommunication() {
	TCE0.INTCTRLB |= TC_CCCINTLVL_MED_gc;
}

void GenTimerE0 :: StopDiffBaroCommunication() {
	TCE0.INTCTRLB &= (0xff ^ (3 << 4));
}
