songcn206/UnMannedParachuteController/Firmware/UnMannedParachuteController/UnMannedParachuteController/HAL/UART/ParseUart.cpp

/*
 * ParseUart.cpp
 *
 * Created: 16.01.2020 16:26:20
 *  Author: timot
 */ 

#include "ParseUart.hpp"

uint8_t ParseExtUart :: parseBufferPos = 0;
uint8_t ParseExtUart :: parseBuffer[ParseExtUart :: parseBufferSize] = {};
volatile uint8_t* ParseExtUart :: arrayStartPointer = DebugUart :: GetRxBufferStart();
volatile uint8_t* ParseExtUart :: arrayEndPointer = DebugUart :: GetRxBufferEnd();
volatile uint8_t* ParseExtUart :: runningPointer = ParseExtUart :: arrayStartPointer;

uint8_t ParseGPSUart :: parseBufferPos = 0;
uint8_t ParseGPSUart :: parseBuffer[ParseGPSUart :: parseBufferSize] = {};
volatile uint8_t* ParseGPSUart :: arrayStartPointer = GpsUart :: GetRxBufferStart();
volatile uint8_t* ParseGPSUart :: arrayEndPointer = GpsUart :: GetRxBufferEnd();
volatile uint8_t* ParseGPSUart :: runningPointer = ParseGPSUart :: arrayStartPointer;

volatile float ParseGPSUart :: longitude;
volatile float ParseGPSUart :: latitude;
volatile float ParseGPSUart :: altitude;
volatile uint8_t ParseGPSUart :: gpsCount;
