songcn206/UnMannedParachuteController/(commit log)

2019-11-30 Initial commit. Adding gitignore and some other files.
    [HammasratasM3D42.SLDASM, MCU.SchDoc, MainSheet.SchDoc, MootoriAdapter.SLDPRT, MootoriRaam.SLDPRT, PololuAB3606HB.SLDPRT, Power.SchDoc, UMParachuteContr.PcbDoc]
2019-11-30 Added MCU. Updated schematic and pcb library
    [MCU.SchDoc]
2019-12-02 Adding uart, mcu and motors
    [Barometers.SchDoc, IMUAndSonar.SchDoc, MCU.SchDoc, MainSheet.SchDoc, Motors.SchDoc, Power.SchDoc, UMParachuteContr.PrjPCB, UartsAndGPS.SchDoc]
2019-12-03 Small modifications. Deleting UartsAndGPS.SchDoc to rename it to Uarts.SchDoc
    [GPS.SchDoc, MCU.SchDoc, MainSheet.SchDoc, Power.SchDoc, UMParachuteContr.PrjPCB, UartsAndGPS.SchDoc]
2019-12-03 Adding Uarts.SchDoc
    [Uarts.SchDoc]
2019-12-03 Added GPS and some capacitors.
    [GPS.SchDoc, MCU.SchDoc, MainSheet.SchDoc, Motors.SchDoc, Power.SchDoc, UMParachuteContr.PrjPCB, Uarts.SchDoc]
2019-12-04 Adding IMU, Sonar, Barometers.
    [Barometers.SchDoc, GPS.SchDoc, IMUAndSonar.SchDoc, Langevarju hoidja.SLDPRT, Langevarju hoidja.STL, MCU.SchDoc, MainSheet.SchDoc, Motors.SchDoc]
2019-12-08 Discussed with Artur
    [IMUAndSonar.SchDoc, MainSheet.SchDoc, Motors.SchDoc, Power.SchDoc, UMParachuteContr.PrjPCB, Uarts.SchDoc]
2019-12-08 Adding stuff
    [Barometers.SchDoc, GPS.SchDoc, IMUAndSonar.SchDoc, MCU.SchDoc, MainSheet.SchDoc, Motors.SchDoc, Power.SchDoc, UMParachuteContr.PrjPCB]
2019-12-09 Some touches on gps and sonar
    [GPS.SchDoc, IMUAndSonar.SchDoc, MCU.SchDoc, MainSheet.SchDoc, Power.SchDoc]
2019-12-10 Updated XTAL
    [GPS.SchDoc, MCU.SchDoc]
2019-12-12 Adding outjob file
    [MCU.SchDoc, UMParachuteContr.PrjPCB]
2019-12-15 Starting PCB
    [Barometers.SchDoc, GPS.SchDoc, IMUAndSonar.SchDoc, MCU.SchDoc, MainSheet.SchDoc, Motors.SchDoc, Power.SchDoc, UMParachuteContr.PcbDoc]
2019-12-18 First board design
    [MCU.SchDoc, Motors.SchDoc, Power.SchDoc, UMParachuteContr.PrjPCB]
2019-12-18 Finishing first design
    [MCU.SchDoc, UMParachuteContr.PrjPCB]
2019-12-19 Some finishing touches of revision 1.0. Needs some footprint checking.
2019-12-21 Final first design.
    [IMUAndSonar.SchDoc, MCU.SchDoc, Motors.SchDoc, UMParachuteContr.PrjPCB]
2020-01-07 Adding UART and Ports
2020-01-09 pins and uart
2020-01-09 PWMTimer, UART and GenericTimer
2020-01-14 Magnetometer works
2020-01-25 Adding gps parse and ADC
2020-01-30 I2C testing
2020-02-06 Testing sensors. Bug found in ParseExtUart
    [Testid.xlsx]
2020-02-08 magnetometer update rate
2020-02-08 Repairing uart parsing issue
    [DataPackets.cpp, DataPackets.hpp, GenTimerD0.cpp, GenTimerD0.hpp, ParseUart.hpp, UART.cpp, UART.hpp, main.cpp]
2020-02-11 Testing IMU
    [Testid.xlsx]
2020-02-11 Testing motors
2020-02-18 Mechanical parts
    [Drooni hoidja.SLDPRT, Esisein.SLDPRT, FeetechFT1117MMotor.SLDPRT, Gear63mm.SLDPRT, Gear65.SLDPRT, HammasratasM3D42.SLDASM, Kaitsekaar.SLDPRT, Katus.SLDPRT]
2020-02-18 Repairing wall.
    [Esisein.SLDPRT, LangevarjuKarpver2.SLDASM]
2020-02-20 Third version
    [Käpp.SLDPRT, LangevarjuKarbiSkelettVer2.SLDPRT, LangevarjuKarbiSkelettVer3.SLDPRT, LangevarjuKarpver3.SLDASM, MainboardRev1.SLDPRT, MootoriAdapterVer2.SLDPRT, NanotechBattery.SLDPRT, PitotToru.SLDPRT]
2020-02-20 Repaired third version.
    [Käpp.SLDPRT, LangevarjuKarbiSkelettVer3.SLDPRT, LangevarjuKarpver3.SLDASM, MainboardRev1.SLDPRT, MootoriAdapterVer2.SLDPRT, NanotechBattery.SLDPRT, PitotToru.SLDPRT, PololuAB3606HB.SLDPRT]
2020-02-22 Adding pitot tube to third version. Also modifying side panels.
    [GPSantenn.SLDPRT, Käpp.SLDPRT, LangevarjuKarbiSkelettVer3.SLDPRT, LangevarjuKarpver3.SLDASM, MainboardRev1.SLDPRT, MootoriAdapterVer3.SLDPRT, NanotechBattery.SLDPRT, PitotToru.SLDPRT]
2020-02-22 Small changes in assembly
    [LangevarjuKarpver3.SLDASM]
2020-02-24 Splitted front wall and middle plate for better printing.
    [Esiseinver3.sldprt, GPSantenn.SLDPRT, Käpp.SLDPRT, LangevarjuKarbiSkelettVer3.SLDPRT, LangevarjuKarpver3.SLDASM, MainboardRev1.SLDPRT, MootoriAdapterVer3.SLDPRT, NanotechBattery.SLDPRT]
2020-02-25 Adding text command to control motor positions.
    [LangevarjuKarbiSkelettVer3.SLDPRT, LangevarjuKarpver3.SLDASM]
2020-03-01 Printed and modified shell parts.
    [Esiseinver3.sldprt, GPSantenn.SLDPRT, Käpp.SLDPRT, LangevarjuKarbiSkelettVer3.SLDPRT, LangevarjuKarpver3.SLDASM, MainboardRev1.SLDPRT, MootoriAdapterVer3.SLDPRT, NanotechBattery.SLDPRT]
2020-03-02 Trying to calibrate motors.
2020-03-03 Some modifications in P controller. Have some problems.
    [DataPackets.cpp, Servos.cpp, Servos.hpp, main.cpp]
2020-03-05 Fixed TickTimer GetTicks function. Added PIDController. Changed degrees to length in mm.
    [GenTimerE0.cpp, GenTimerE0.hpp, ParseUart.hpp, Servos.cpp, Servos.hpp, TickTimer.cpp, TickTimer.hpp]
2020-03-24 Updating schematics.
    [Barometers.SchDoc, GPS.SchDoc, Käpp.SLDPRT, LangevarjuKarpver3.SLDASM, MCU.SchDoc, Motors.SchDoc, Power.SchDoc, SonarMB1023.SLDPRT]
2020-03-31 PCB revision 1.1.
    [IMUAndSonar.SchDoc, MCU.SchDoc, Motors.SchDoc, Power.SchDoc, Uarts.SchDoc]
2020-04-02 Adding zener diode and battery voltage monitor.
    [Power.SchDoc]
2020-04-06 Revision 1.1 finished. Maybe needs some final adjustments.
    [GPS.SchDoc, IMUAndSonar.SchDoc, MCU.SchDoc, MainSheet.SchDoc, Motors.SchDoc, Power.SchDoc, UMParachuteContr.PrjPCB, Uarts.SchDoc]
2020-04-07 Adjusting schematic layout.
    [IMUAndSonar.SchDoc, MCU.SchDoc, Power.SchDoc, UMParachuteContr.PrjPCB]
2020-04-09 Updating UART pin config.
2020-04-09 Repairing some bugs in PCB design.
    [IMUAndSonar.SchDoc, Power.SchDoc]
2020-04-09 Changing 5V layout.
    [MCU.SchDoc, Motors.SchDoc]
2020-04-13 Refactoring schematic components.
    [Barometers.SchDoc, GPS.SchDoc, IMUAndSonar.SchDoc, MCU.SchDoc, MainSheet.SchDoc, Motors.SchDoc, Power.SchDoc, Uarts.SchDoc]
2020-04-21 Finishing PCB design for revision 1.1.
    [Barometers.SchDoc, Esisein.SLDPRT, GPS.SchDoc, IMUAndSonar.SchDoc, Käppver2.SLDPRT, LangevarjuKarp.SLDASM, LangevarjuKarpver2.SLDASM, MCU.SchDoc]
2020-04-22 Refactoring code for pcb revision 1.1.
2020-04-23 Testing IMU and absolute barometer.
2020-04-23 Updating sensors refresh rate.
2020-04-25 Adding EEPROM SPI communication.
2020-04-27 Data saving to EEPROM and updating PID controller values. Also adding breaking before landing. Different speeds for data saving and sending.
2020-05-02 Changing IMU filter alpha constant. Adding 02.05.2020 test results.
    [Katsed02052020.xlsx]
2020-05-02 Updating EEPROM writing.
    [Katsed02052020.xlsx]
2020-05-08 Updating PID constants.
    [Katsed02052020.xlsx]
2020-05-16 Refactoring Git structure.
    [Katsed02052020.xlsx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]
